HikariBoy/DistanceSensorLogger/FigPrep.pptx

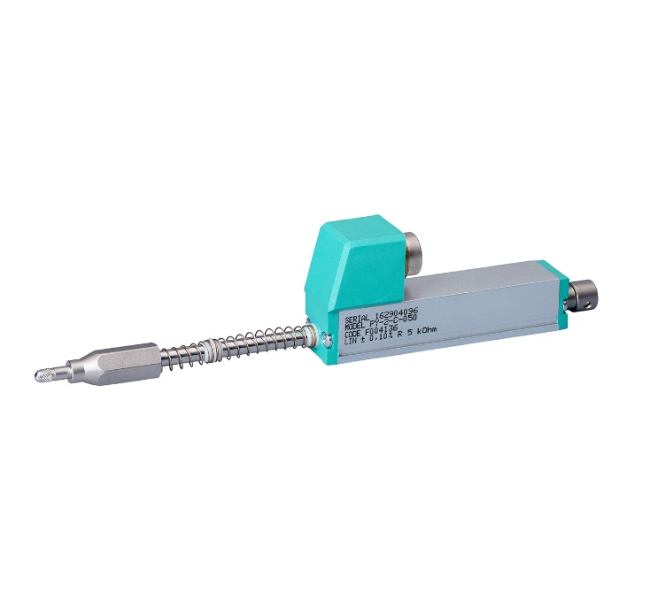
[picture p7: figure]

black

Yellow

Arduino 3.3V

ADS1115 ADC ->A0

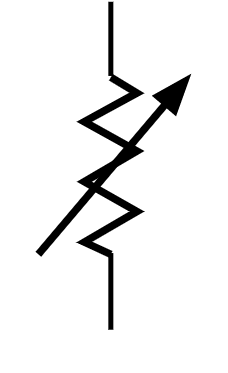
[picture p8: figure]

1 KΩ

outer
sheath

brown

Arduino GND

## Slide 2

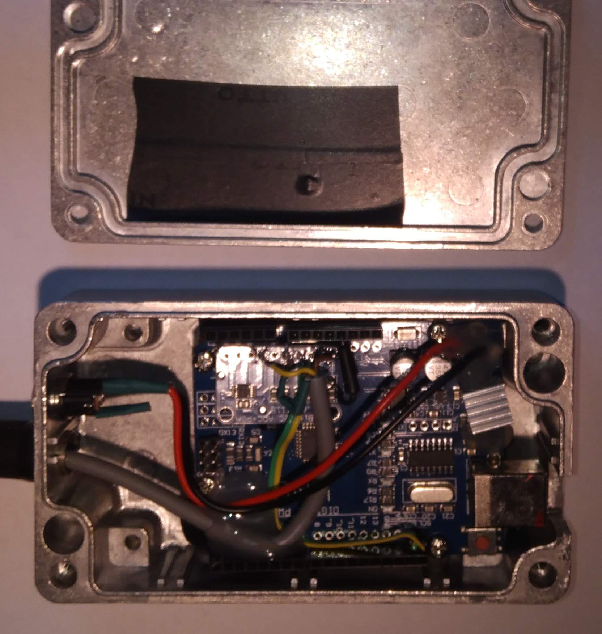
[picture p9: figure]

From GEFRAN PY2 connector

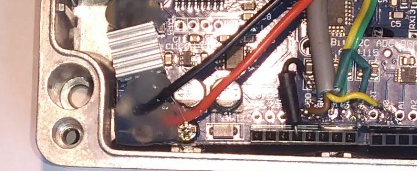
[picture p10: figure]

USB I/O

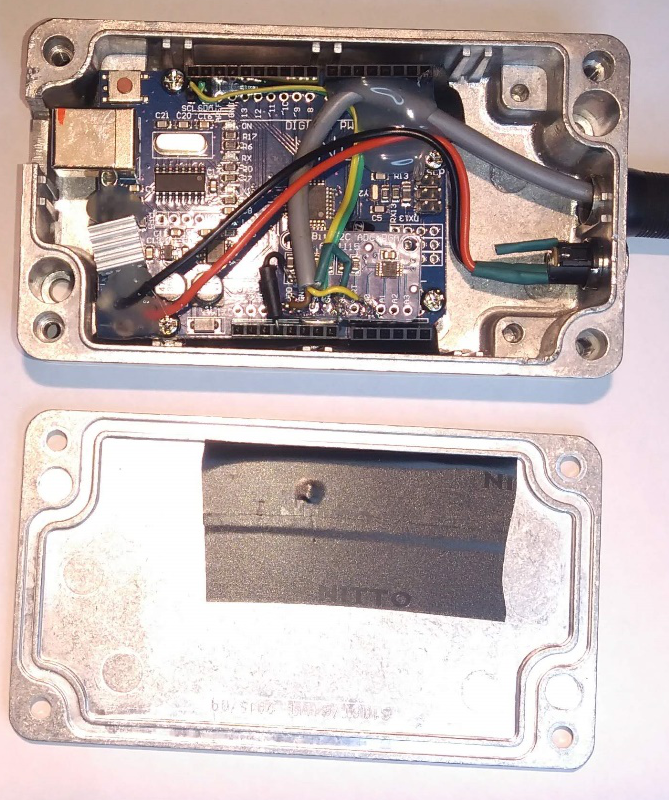
[picture p11: figure]

(b)

(a)

Heatsink
(also contacts lid for
better conduction)

3.3V

GND

ADS1115
ADC ->A0

Power jack removed – direct wired to panel mount 2.5mm socket

Insulation on lid to prevent short to ADS1115 ADC

Heatsink touches lid here for better conduction

(c)

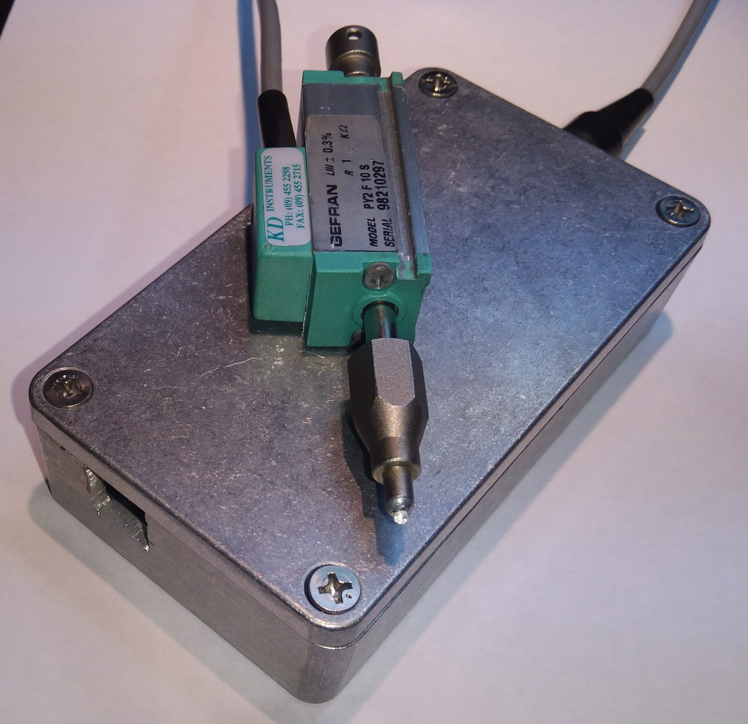
[picture p12: figure]
