HikariBoy/DistanceSensorLogger/GEFRAN_DistanceSensor.sch

## EAGLE design GEFRAN_DistanceSensor.sch (2020-01-01)

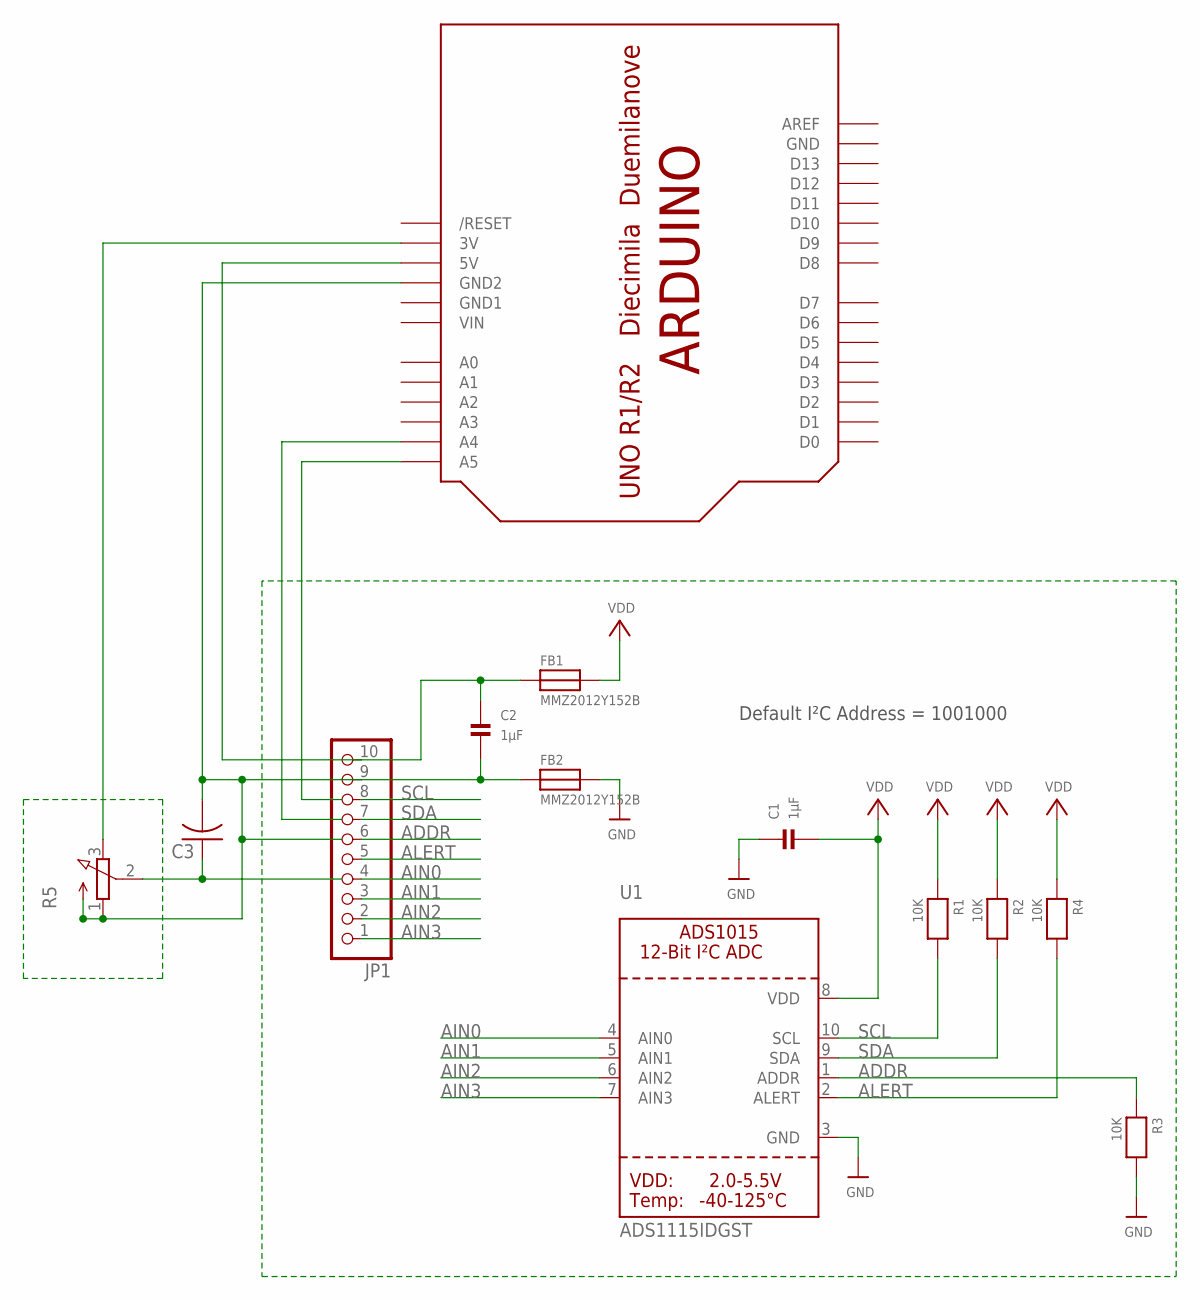
[picture p13: schematic GEFRAN_DistanceSensor.sch]

Parts:
C1, C2: 1µF; 0805
C3: C-US025-024X044; C025-024X044
FB1, FB2: MMZ2012Y152B; 0805
JP1: HEADER-1X1070MIL; 1X10_ROUND70
R1, R2, R3, R4: 10K; 0805
R5: 3RP/1610N
U1: ADS1115IDGST; MSOP10
U$7: ARDUINOUNO; ARDUINO

Connections:
ADDR: JP1.6, R3.1, U1.1 (ADDR)
AIN0: JP1.4, U1.4 (AIN0)
AIN1: JP1.3, U1.5 (AIN1)
AIN2: JP1.2, U1.6 (AIN2)
AIN3: JP1.1, U1.7 (AIN3)
ALERT: JP1.5, R4.2, U1.2 (ALERT)
GND: C1.1, FB2.2, R3.2, U1.3 (GND)
unnamed: C2.1, FB1.1, JP1.10, U$7.5V
unnamed: C2.2, C3.2, FB2.1, JP1.9, R5.1 (A), U$7.A5, U$7.GND2
unnamed: C3.1, R5.2 (S)
unnamed: R5.3 (E), U$7.3V
SCL: JP1.8, R1.2, U1.10 (SCL)
SDA: JP1.7, R2.2, U1.9 (SDA)
VDD: C1.2, FB1.2, R1.1, R2.1, R4.1, U1.8 (VDD)

Notes on the sheet:
Default I²C Address = 1001000
