HikariBoy/DistanceSensorLogger/TestingData.xlsx

Sheet: Repeatability Test
Output from distanceSensor.ino with sensor initially at maximum extent bolted to desk with the tip on the desk.
RAW ADC | Calibrated (microns) |  | selected only
Hello!
Getting single-ended readings from AIN0..3 |  |  |  |  | Statistics
ADC Range: +/- 6.144V (1 bit | 3mV) |  |  | Small movement of rod of PY2 sensor |  | Average | 2.164
330.1 | 0.1 |  |  |  |  | standard deviation | 5.263453565
330.05 | 0.1
329.8 | 0 |  |  | Large movement of rod of PY2 sensor |  | Average | -13.56285714
330 | 0.1 |  |  |  |  | standard deviation | 9.75330745
330.15 | 0.2
330.05 | 0.1
329.85 | 0
329.85 | 0
329.95 | 0.1
330.1 | 0.1
330.05 | 0.1
329.85 | 0
329.95 | 0.1
329.95 | 0.1
330.1 | 0.1
329.8 | 0
330 | 0.1
330.1 | 0.1
330 | 0.1
330 | 0.1
329.95 | 0.1
330 | 0.1
329.8 | 0
329.85 | 0
330.05 | 0.1
330 | 0.1
330 | 0.1
330 | 0.1
330 | 0.1
330 | 0.1
330 | 0.1
330 | 0.1
330 | 0.1
329.95 | 0.1
330.05 | 0.1
330.05 | 0.1
330 | 0.1
330.05 | 0.1
330 | 0.1
329.95 | 0.1
329.9 | 0
329.95 | 0.1
329.9 | 0
329.7 | -0.1
330.55 | 0.4
330.1 | 0.1
330.3 | 0.3
329.95 | 0.1
330.05 | 0.1
330.25 | 0.2
329.75 | -0.1
330 | 0.1
329.75 | -0.1
329.7 | -0.1
330.35 | 0.3
329.85 | 0
330.05 | 0.1
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
