HikariBoy/DistanceSensorLogger/Tests.ods

Sheet: Sheet1
0.5772604056

Sheet: Sheet2
RAW ADC | Calibrated (microns) |  | selected only
Hello!
Getting single-ended readings from AIN0..3
ADC Range: +/- 6.144V (1 bit | 3mV)
330.1 | 0.1
330.05 | 0.1
329.8 | 0
330 | 0.1
330.15 | 0.2
330.05 | 0.1
329.85 | 0
329.85 | 0
329.95 | 0.1
330.1 | 0.1
330.05 | 0.1
329.85 | 0
329.95 | 0.1
329.95 | 0.1
330.1 | 0.1
329.8 | 0
330 | 0.1
330.1 | 0.1
330 | 0.1
330 | 0.1
329.95 | 0.1
330 | 0.1
329.8 | 0
329.85 | 0
330.05 | 0.1
330 | 0.1
330 | 0.1
330 | 0.1
330 | 0.1
330 | 0.1
330 | 0.1
330 | 0.1
330 | 0.1
329.95 | 0.1
330.05 | 0.1
330.05 | 0.1
330 | 0.1
330.05 | 0.1
330 | 0.1
329.95 | 0.1
329.9 | 0
329.95 | 0.1
329.9 | 0
329.7 | -0.1
330.55 | 0.4
330.1 | 0.1
330.3 | 0.3
329.95 | 0.1
330.05 | 0.1
330.25 | 0.2
329.75 | -0.1
330 | 0.1
329.75 | -0.1
329.7 | -0.1
330.35 | 0.3
329.85 | 0
330.05 | 0.1
329.65 | -0.1
329.8 | 0
329.75 | -0.1
329.65 | -0.1
330.05 | 0.1
330.3 | 0.3
329.6 | -0.1
329.7 | -0.1
329.9 | 0
329.95 | 0.1
329.9 | 0 | 0
329.9 | 0 | TRUE | 0 | 2.164
327.6 | -1.3 | TRUE | -1.3 | 5.2634535653
325.1 | -2.7 | TRUE | -2.7
322.5 | -4.2 | TRUE | -4.2 | -13.5628571429
632.2 | 174.5 | TRUE |  | 9.7533074498
1560.7 | 710.5 | TRUE
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
