HikariBoy/DistanceSensorLogger/(commit log)

2020-01-01 Major text fixes and typos checked
    [GEFRAN_DistanceSensor.sch]
2020-01-01 addition of calibration and testing section
    [TestingData.xlsx, Tests.ods]
